Circuitos-Digitales-UNMSM-G2/Grupo-1---Proyecto-Digitales---Analizador-de-ocupacion-de-bandas-ISM/README.md

"# Grupo-1---Proyecto-Digitales---Analizador-de-ocupaci-n-de-bandas-ISM" 

# Grupo-1---Proyecto-Digitales---Analizador-de-ocupacion-de-bandas-ISM
