Circuitos-Digitales-UNMSM-G2/Grupo-1---Proyecto-Digitales---Analizador-de-ocupacion-de-bandas-ISM/ENTREGABLE 04 - Grupo 1/ENTREGABLE 4.pdf

# Analizador inteligente de ocupación en bandas ISM mediante sistema digital con

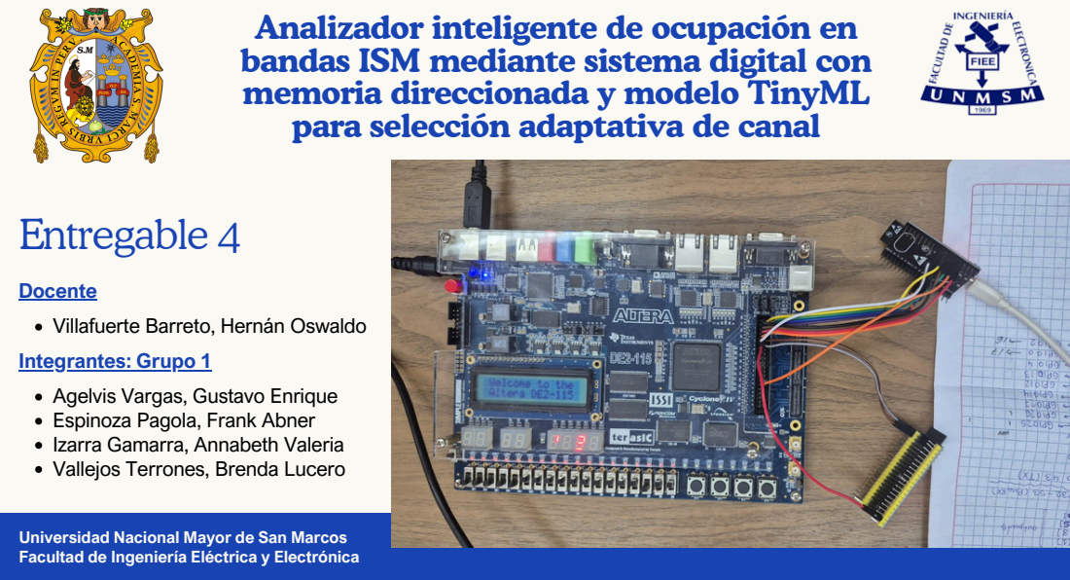
[picture p1: page 1]
Entregable 4

memoria direccionada y modelo TinyML
para selección adaptativa de canal

Docente
Villafuerte Barreto, Hernán Oswaldo
Integrantes: Grupo 1
Agelvis Vargas, Gustavo Enrique
Espinoza Pagola, Frank Abner
Izarra Gamarra, Annabeth Valeria
Vallejos Terrones, Brenda Lucero

Universidad Nacional Mayor de San Marcos
Facultad de Ingeniería Eléctrica y Electrónica

# HARDWARE Y CONEXIONES

# Diagrama de conexiones generales

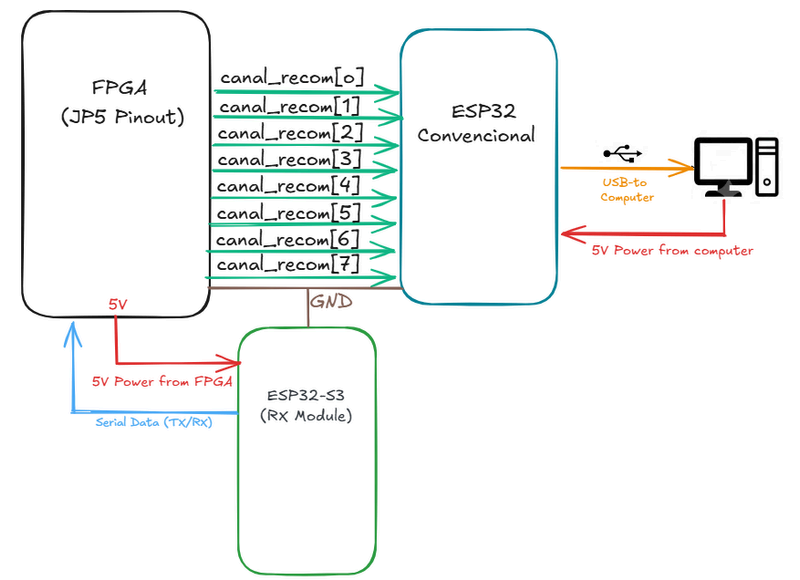
[picture p2: figure]

Pinout | Emisor

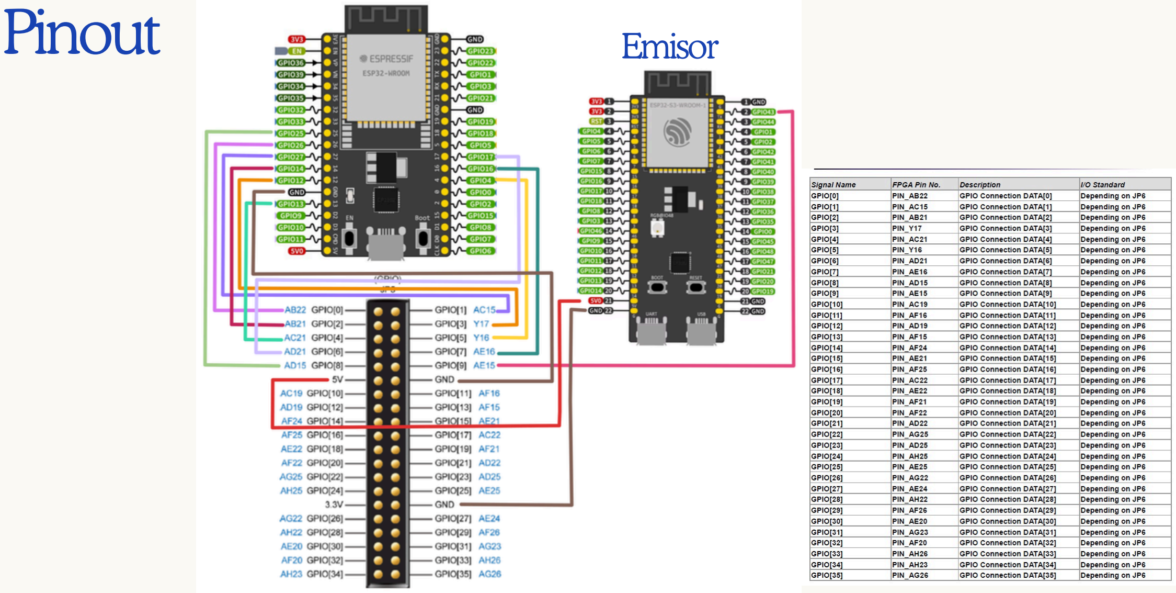
[picture p3: page 4]

SEÑAL FPGA | PIN FPGA | GPIO ESP32 | FUNCIÓN
canal_recomendado[0] | AB22 (GPIO0) | GPIO26 | Bit 0 del canal recomendado
canal_recomendado[1] | AC15 (GPIO1) | GPIO27 | Bit 1 del canal recomendado
canal_recomendado[2] | AB21 (GPIO2) | GPIO14 | Bit 2 del canal recomendado
canal_recomendado[3] | Y17 (GPIO3) | GPIO12 | Bit 3 del canal recomendado
canal_recomendado[4] | AC21 (GPIO4) | GPIO13 | Bit 4 del canal recomendado
canal_recomendado[5] | Y16 (GPIO5) | GPIO4 | Bit 5 del canal recomendado
canal_recomendado[6] | AD21 (GPIO6) | GPIO17 | Bit 6 del canal recomendado
canal_recomendado[7] | AE16 (GPIO7) | GPIO16 | Bit 7 del canal recomendado
output_valid | AD15 (GPIO8) | GPIO25 | Validación de datos

Conexión con ESP32-S3 (emisor)

UART RX (desde ESP32-S3) | AE15 (GPIO1) | GPIO43 (TX del ESP32-S3)

Recepción de datos de ocupación y RSSI

Alimentación y tierra

Tierra común | GND | GND | Referencia eléctrica común
Alimentación | 5V FPGA | 5V ESP32-S3 | Alimentación del módulo emisor

# Pinout

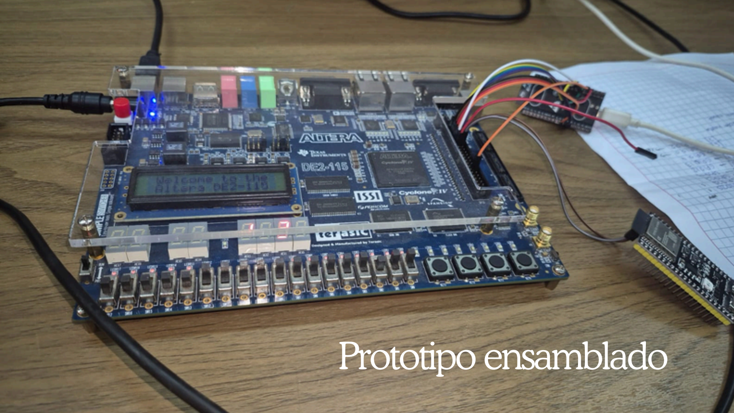
[picture p4: page 6]

# Prototipo ensamblado

# Prototipo ensamblado

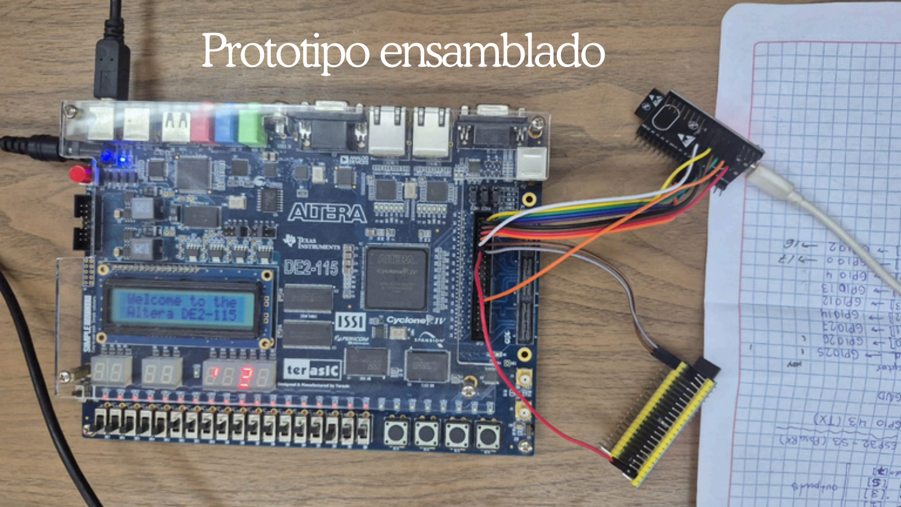
[picture p5: page 7]

RECURSO | UTILIZADO | DISPONIBLE | PORCENTAJE
Elementos lógicos (LUTs) | 350 | 114 480 | < 1 %
Funciones combinacionales | 272 | 114 480 | < 1 %

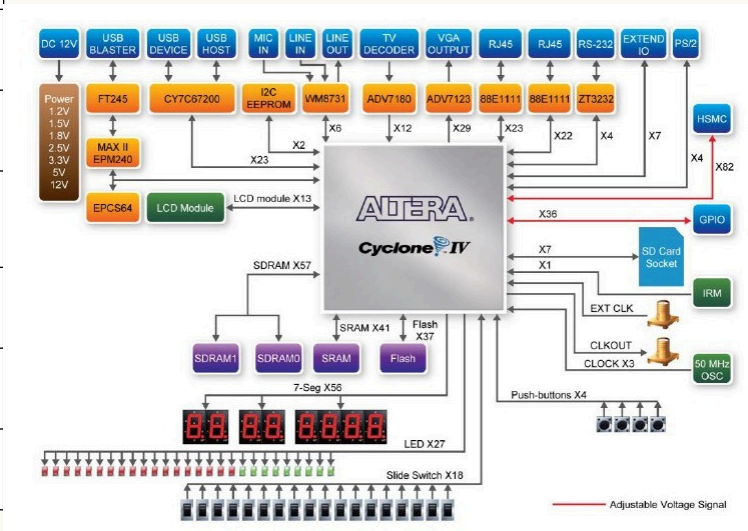
[picture p6: figure]

Registros dedicados (Flip-Flops) | 235 | 114 480 | < 1 %
Pines de entrada/salida (I/O) | 43 | 529 | 8%
Bits de memoria RAM | 0 | 3 981 312 | 0%
Bloques de memoria M9K | 0 | 432 | 0%
Multiplicadores embebidos de 9 bits | 0 | 532 | 0%
PLLs | 0 | 4 | 0%

# RECURSOS OCUPADOS DEL FPGA

El reporte de compilación muestra una ocupación muy reducida de los recursos disponibles de la FPGA. Se emplearon únicamente 350 elementos lógicos, 235 registros y 43 pines de entrada/salida, manteniendo un amplio margen de capacidad libre para futuras mejoras del sistema.

PROGRAMA | FUNCIÓN PRINCIPAL | PLATAFORMA

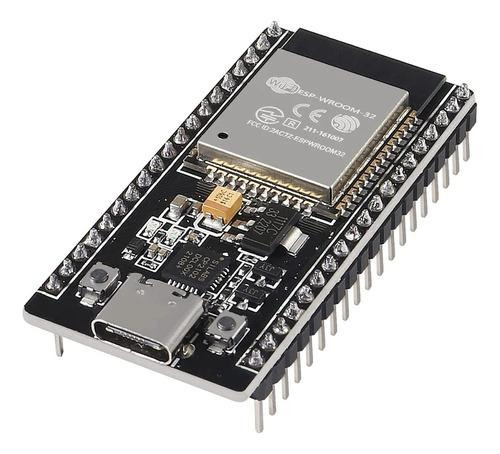
[picture p7: figure]

scanner_sender.ino | Escaneo de redes WiFi y envío de métricas a la FPGA mediante UART | ESP32-S3 DevKitC-1
ap_receiver.ino | Recepción del canal recomendado desde la FPGA y configuración de un punto de acceso WiFi | ESP32 Dev Module
simulator_sender.ino | Envío de escenarios simulados a la FPGA para pruebas y validación | ESP32
PROGRAMA | TAMAÑO DEL FIRMWARE (.bin)
scanner_sender | 676 528 bytes (660.67 KB)
ap_receiver | 733 920 bytes (716.72 KB)

# Recursos Ocupados en los ESP32

El sistema utiliza dos módulos ESP32 con funciones complementarias. El ESP32-S3 realiza el escaneo de redes WiFi y envía las métricas a la FPGA mediante UART, mientras que el ESP32 receptor interpreta el canal recomendado y configura un punto de acceso inalámbrico utilizando dicho canal.

## Memoria utilizada Los firmwares compilados presentan tamaños inferiores a 1 MB, lo que representa un uso moderado de la memoria Flash disponible en los

ESP32.

RECURSO | FUNCIÓN
Arduino.h | Funciones básicas del framework Arduino
WiFi.h | Escaneo y administración de redes WiFi
Serial | Comunicación serie con la computadora
Serial2 | Comunicación UART con la FPGA
digitalRead() | Lectura de entradas digitales
attachInterrupt() | Gestión de interrupciones
WiFi.scanNetworks() | Escaneo de redes inalámbricas
WiFi.softAP() | Creación de punto de acceso WiFi

# Recursossoftware

## El desarrollo emplea bibliotecas estándar del ecosistema Arduino y ESP32, incluyendo:

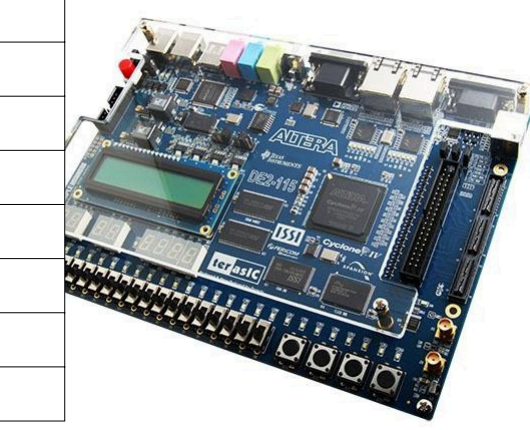
[picture p8: figure]

## Los módulos ESP32 funcionan como interfaces de adquisición y comunicación, mientras que el procesamiento principal se realiza en la FPGA. La arquitectura distribuye eficientemente las tareas y mantiene un bajo consumo de recursos de memoria y

almacenamiento.

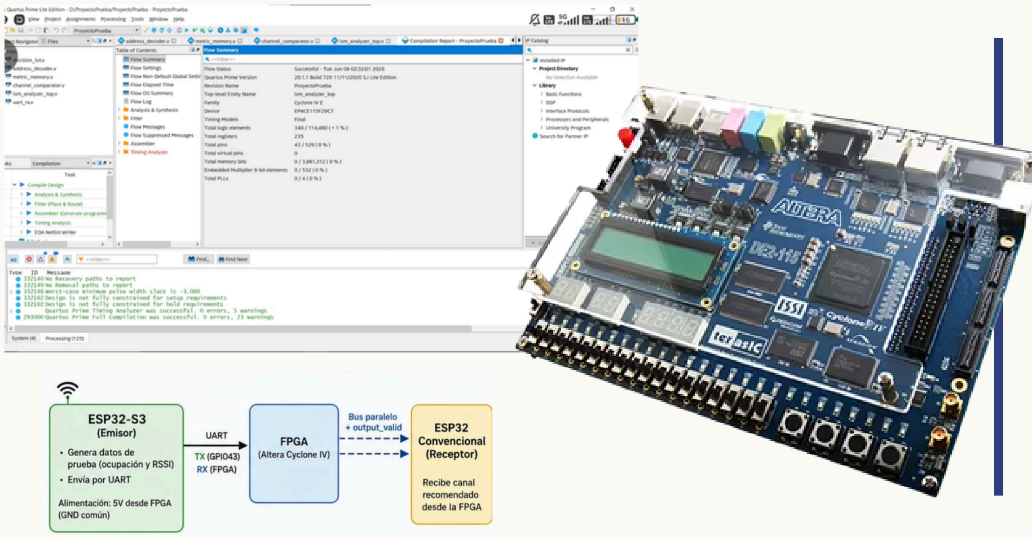
[picture p9: page 11]

CANAL | RSSI (%) | OCUPACIÓN (%)
Canal 1 | 75 | 55
Canal 6 | 65 | 15
Canal 11 | 60 | 60

# MEDICIÓN DE MÉTRICAS INICIALES

Los módulos ESP32 funcionan como interfaces de adquisición y comunicación, mientras que el procesamiento principal se realiza en la FPGA. La arquitectura distribuye eficientemente las tareas y mantiene un bajo consumo de recursos de memoria y almacenamiento.

# Escenario de prueba

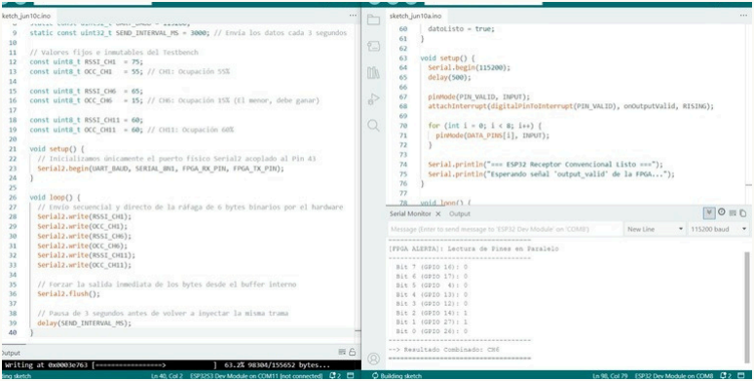
[picture p10: figure]

## Resultado esperado Canal recomendado = CH6 Porque presenta el menor nivel de

ocupación.

PARÁMETRO | VALOR
Tiempo por bit UART | 8.68 µs
Tiempo por byte UART | 86.8 µs
Número de bytes transmitidos | 6
Tiempo total de transmisión | 520.8 µs
Pausa agregada por testbench | 120 µs
Tiempo de procesamiento FPGA | 0.24 µs
Tiempo total estimado | 641.04 µs
PARÁMETRO | SIMULACIÓN | HARDWARE REAL
Canal recomendado | CH6 | CH6
Valor binario obtenido | 110 | 110
Valor decimal obtenido | 6 | 6
Señal output_valid | Activa | Activa
Resultado esperado | Correcto | Correcto
Tiempo de respuesta aproximado | 641.04 µs | 520.8 µs + procesamiento

# MEDICIÓN DE MÉTRICAS INICIALES

# Parámetros delsistema Resultados Simulados vs Reales

# Análisis y contraste

Simulación y hardware obtuvieron el mismo resultado (Canal 6).
La simulación presentó mayor latencia debido a retardos añadidos en el testbench.
La FPGA opera a 50 MHz, muy por debajo de su Fmax de 157.28 MHz, garantizando un funcionamiento estable. La baja utilización de recursos permite futuras ampliaciones del sistema sin afectar el rendimiento.

# ESP32 -WROOM32

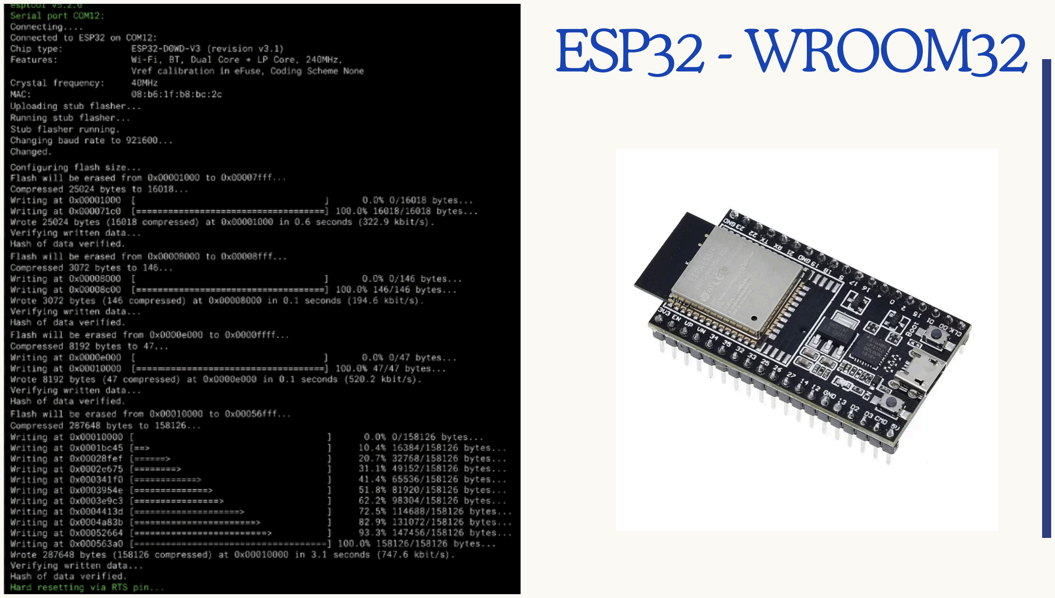
[picture p11: page 14]

# ESP32-S3 Dev Kit

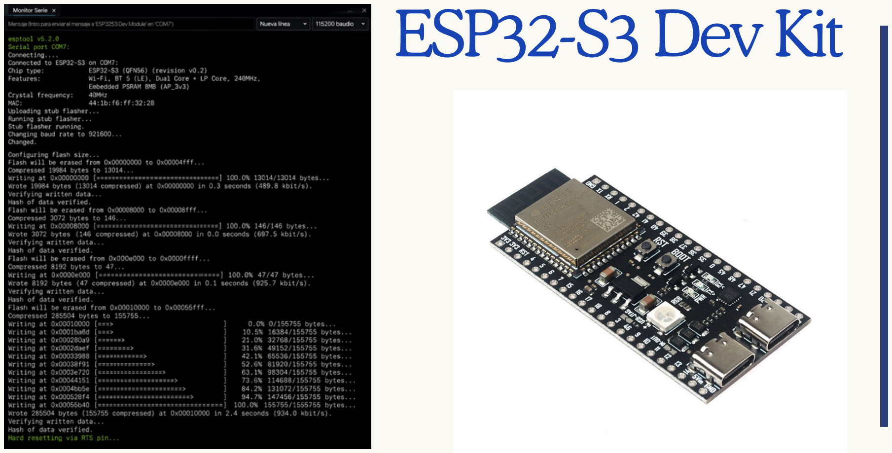
[picture p12: page 15]

# EVIDENCIA DE FUNCIONAMIENTO

# hht

t

t

# tppss

:/
:

/

# /y/yoouut

# tuu.b

# .bee/Z/Zwwhhxx

# zzbbEEeeRRf4f (https://youtu.be/ZwhxzbEeRf4)4 (https://youtu.be/ZwhxzbEeRf4)

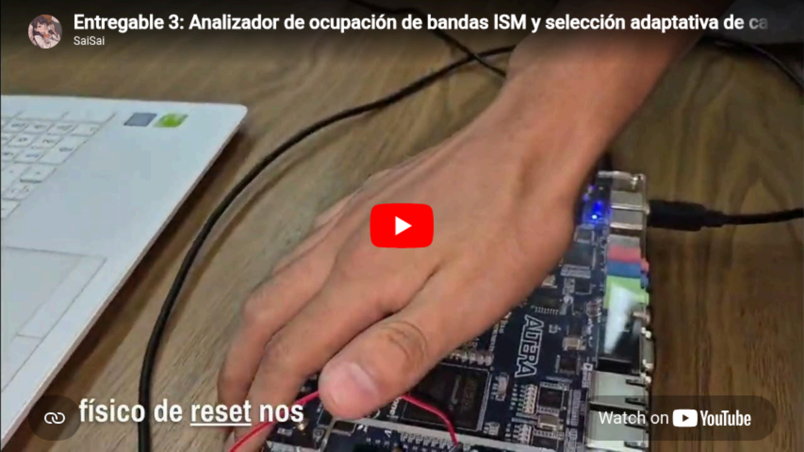
[picture p13: page 17]

# Sección 1: Prototipo físico ensamblado y funcional

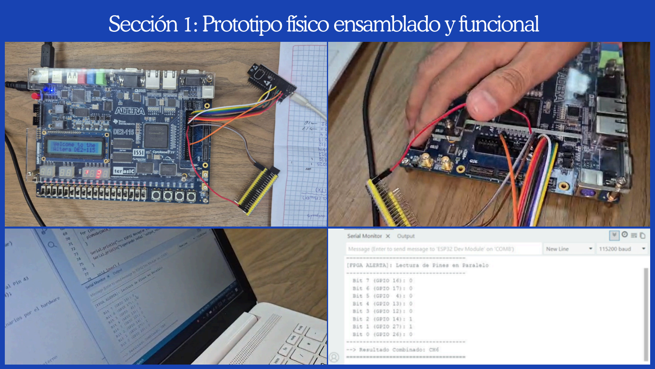
[picture p14: page 18]

Sección 2: Resultado de la lógica de decisión del prototipo físico en monitorserial.

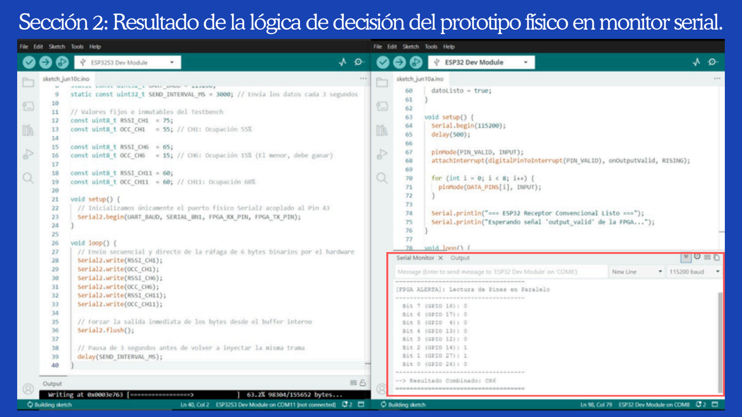
[picture p15: page 19]

# Sección 3:

# Testbench

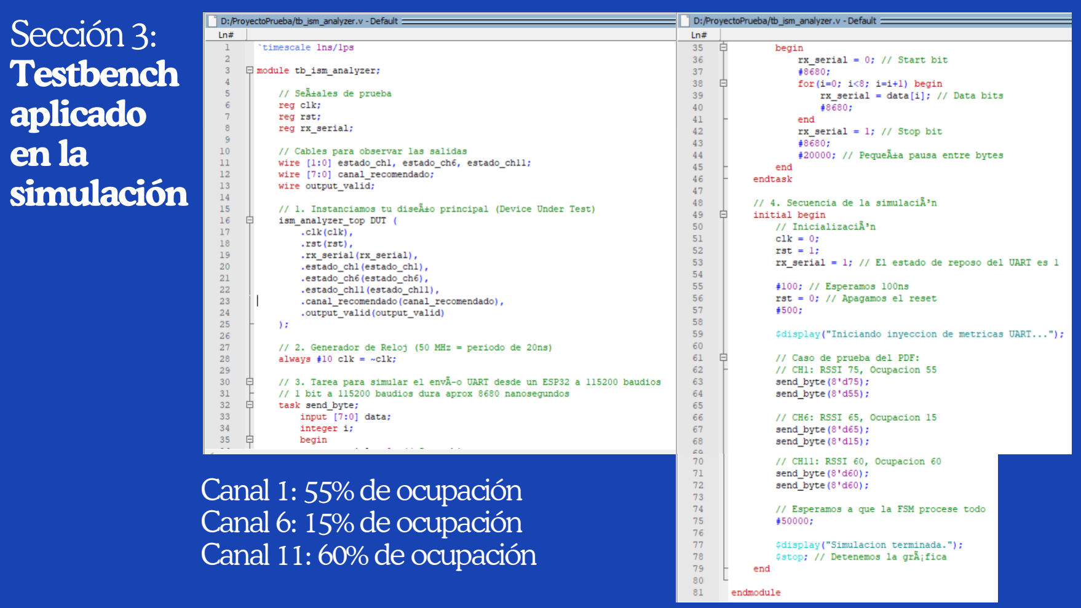
[picture p16: page 20]

# aplicado en la simulación

# Canal 1: 55% de ocupación Canal 6: 15% de ocupación Canal 11: 60% de ocupación

# Sección 4: Resultado de la simulación tras aplicación del testbench

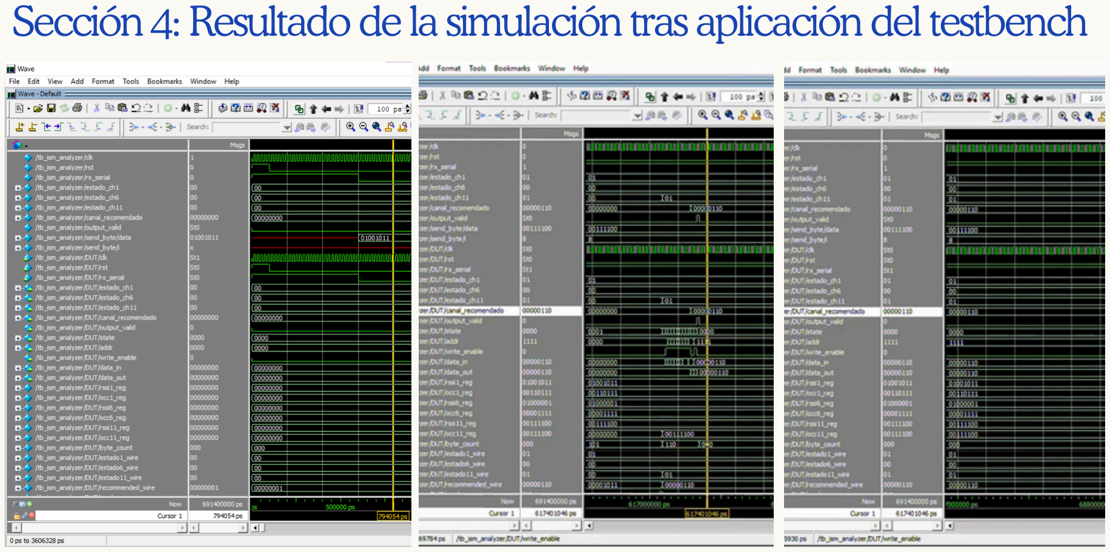
[picture p17: page 21]

# Presentación del Proyecto

# Materiales

## El proyecto implementa un sistema digital capaz de analizar métricas de ocupación de canales WiFi en la banda ISM, almacenar

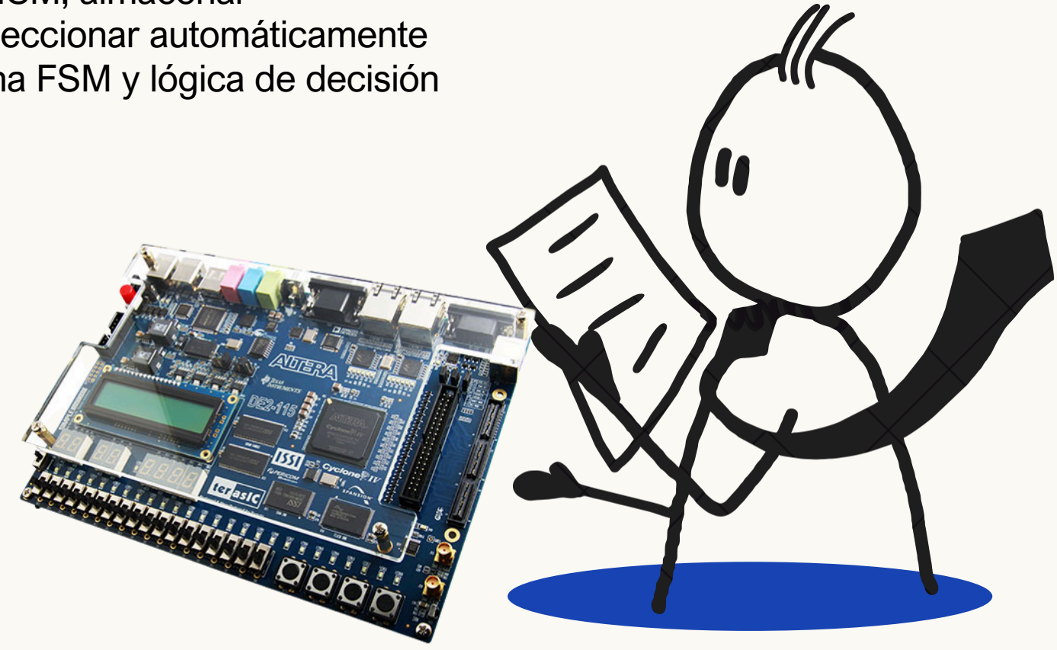
[picture p18: figure]

## información en memoria direccionada y seleccionar automáticamente el canal menos congestionado mediante una FSM y lógica de decisión

LUT implementadas en FPGA.

## FPGA DE2-115 (Cyclone IV E) ESP32-S3 Laptop con Quartus Prime y ModelSim Cable USB-Blaster

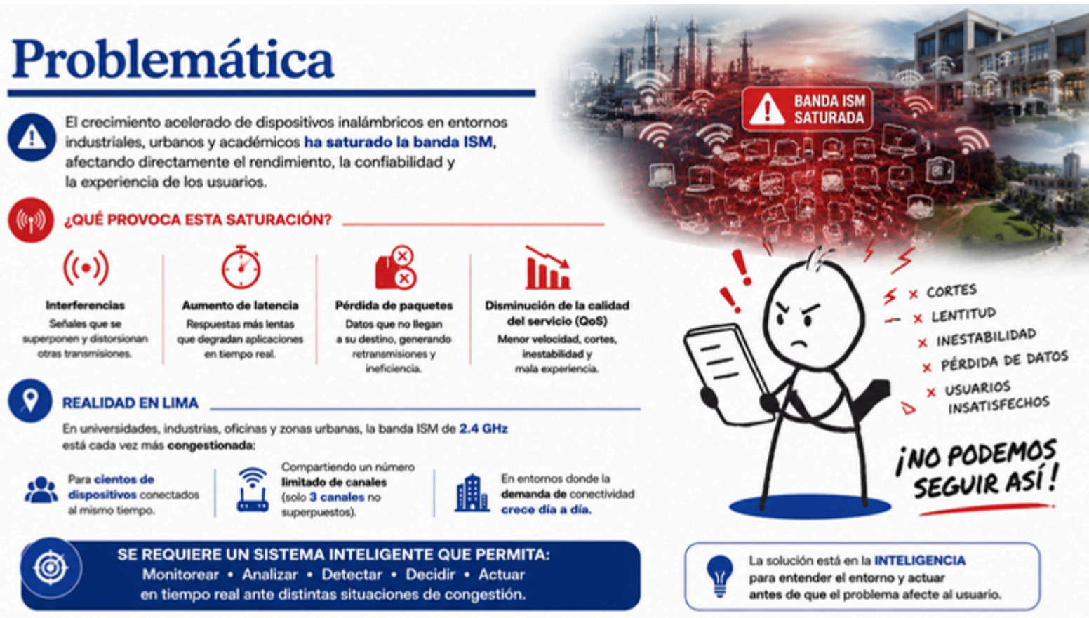
[picture p19: page 24]

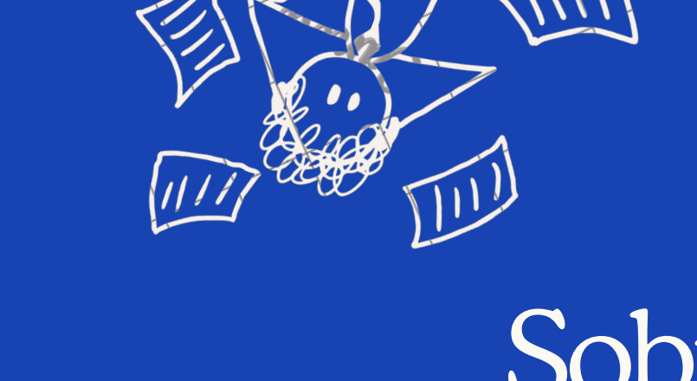
[picture p20: figure]
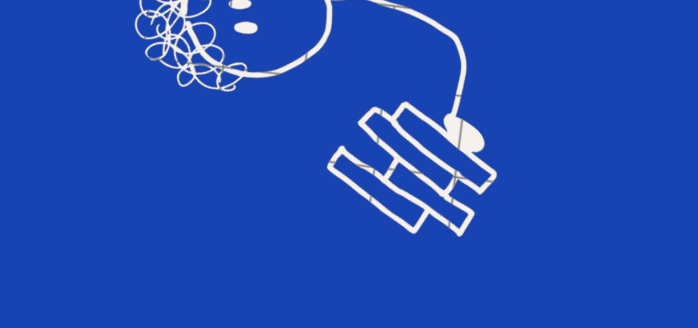
[picture p21: figure]

# Sobre la situación actual

La situación está en que muchas tecnologías no plantean un mecanismo local tanto económico como autónomo

## que pueda analizar la actividad de distintas bandas

Este dispositivo se basaría en parámetros como calidad de transmisión, potencia, entre otros para poder tomar decisiones digitales que mejoren el desempeño del enlace. Lo cual, cuando se observa el sector IoT notamos que muchos utilizan configuraciones estáticas sin considerar lo mencionado anteriormente.

Abdelghany, A., Uguen, B., Moy, C., & Lemur, D. (2022). Decentralized Adaptive Spectrum Learning in Wireless IoT Networks Based on Channel Quality Information.

# Fuente

# Objetivos

# Generales

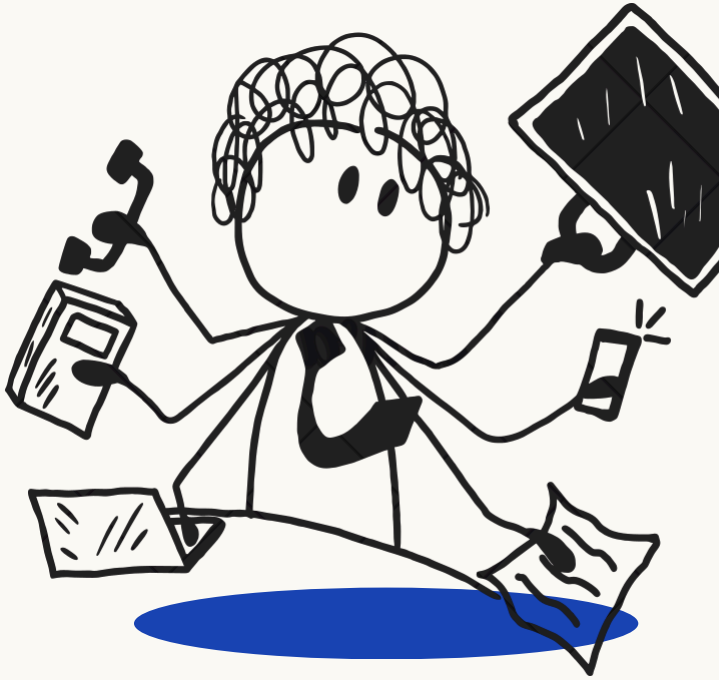
[picture p22: figure]

# Específicos

Diseñar una FSM para controlar el flujo del sistema.

## Implementar memoria direccionada y decodificador de

direcciones.

## Validar mediante simulación funcional la selección automática

del canal menos congestionado.

## Desarrollar un sistema digital inteligente para análisis y selección

adaptativa de canales en banda ISM utilizando FPGA.

En un entorno industrial con múltiples dispositivos IoT, redes WiFi,

## sensores NB-IoT, cámaras y sistemas de automatización transmitiendo simultáneamente en la banda ISM, puede producirse congestión e interferencia que afecte la estabilidad y latencia de las

comunicaciones críticas.

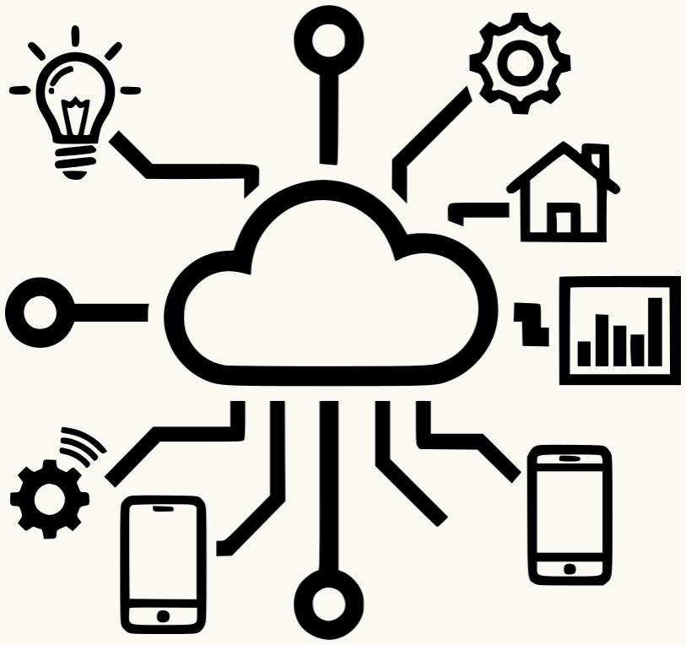
[picture p23: figure]

En este escenario, el sistema propuesto monitorea continuamente la ocupación de los canales inalámbricos mediante el ESP32-S3 y envía las métricas hacia la FPGA, donde son procesadas en tiempo real mediante FSM, memoria direccionada y lógica de decisión LUT para identificar el canal menos congestionado. Esto permite recomendar o ejecutar cambios dinámicos de canal para mantener una comunicación más estable, reducir pérdida de paquetes y mejorar la

confiabilidad de sistemas industriales conectados.

# Casos de uso

## A diferencia de un microcontrolador convencional, la FPGA puede controlar simultáneamente módulos de memoria, decodificación de direcciones, clasificación LUT y comparación de canales mediante una FSM dedicada

El uso de una FPGA permite implementar el procesamiento y la toma de decisiones directamente en

## hardware digital, logrando una ejecución paralela y determinística con baja latencia

# Valor agregado

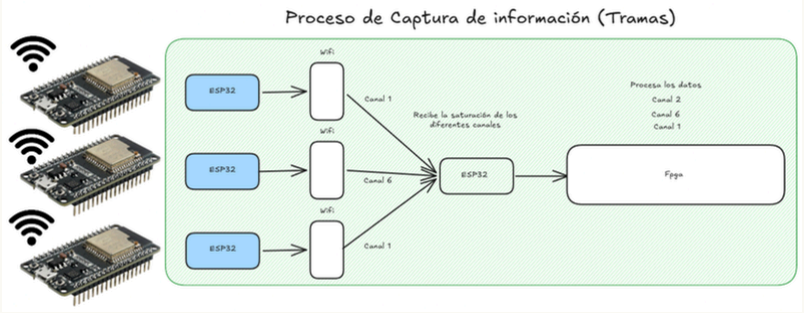
[picture p24: figure]

# De forma general la propuesta de proyecto

# Diagrama de bloques

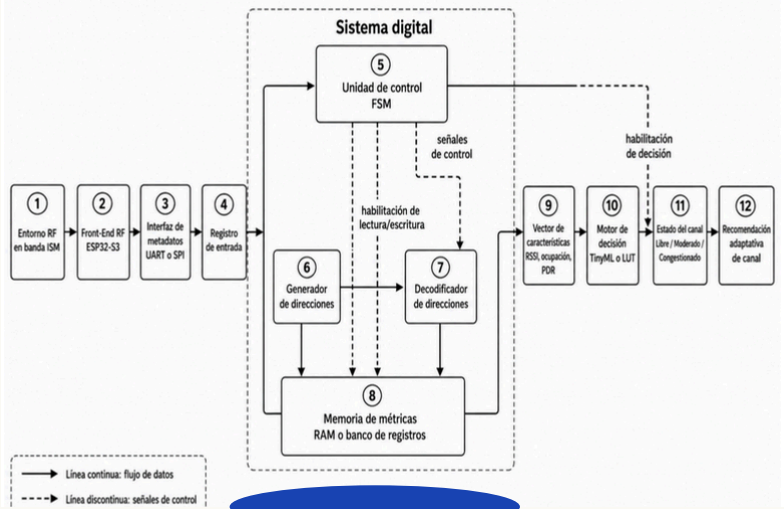
[picture p25: figure]

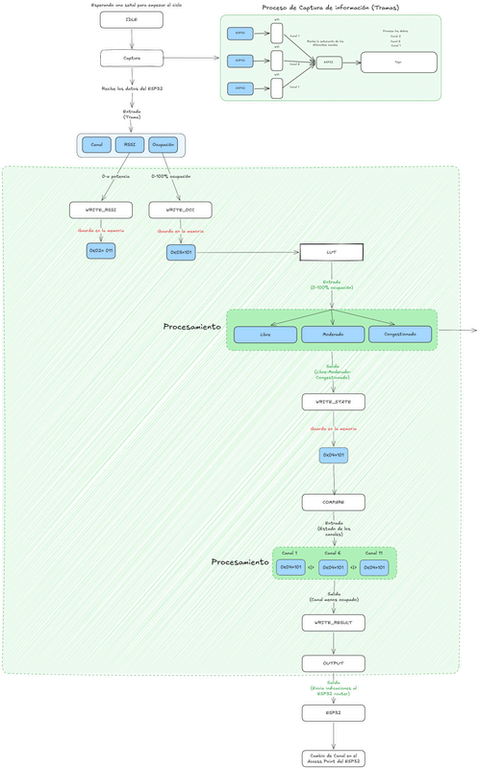
[picture p26: figure]

# Arquitectura delsistema

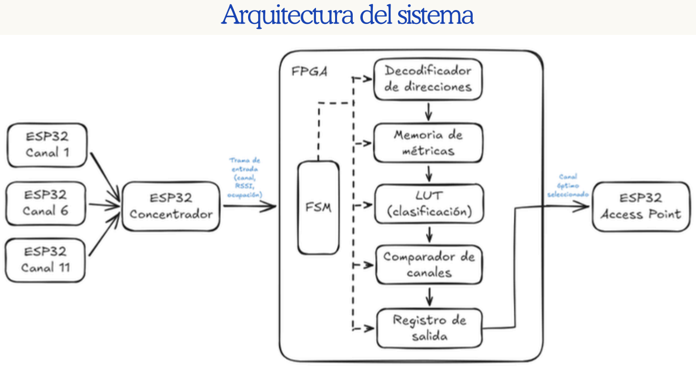
[picture p27: page 32]

# Máquina de estadosfinitos(FSM)

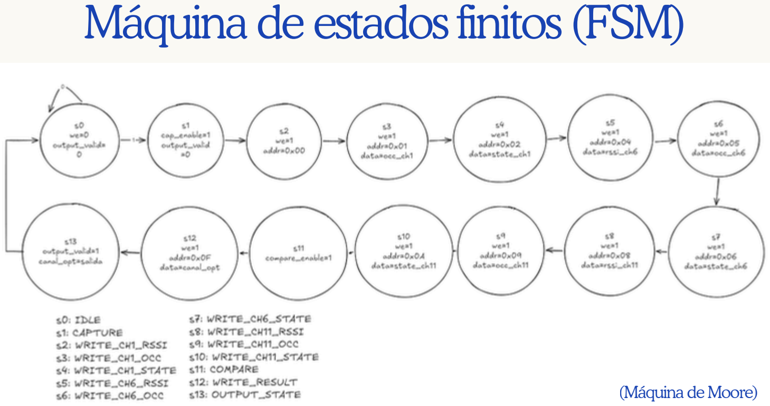
[picture p28: page 33]

# (Máquina de Moore)

Código | Estado | Función | Siguiente estado
0 | IDLE | Espera una trama válida | CAPTURE si data_valid = 1
1 | CAPTURE | Captura RSSI y ocupación de los canales 1, 6 y 11 | WRITE_CH1_RSSI
2 | WRITE_CH1_RSSI | Escribe RSSI del canal 1 en memoria | WRITE_CH1_OCC
3 | WRITE_CH1_OCC | Escribe ocupación del canal 1 | WRITE_CH1_STATE
4 | WRITE_CH1_STATE | Escribe estado clasificado del canal 1 | WRITE_CH6_RSSI
5 | WRITE_CH6_RSSI | Escribe RSSI del canal 6 en memoria | WRITE_CH6_OCC
6 | WRITE_CH6_OCC | Escribe ocupación del canal 6 | WRITE_CH6_STATE
7 | WRITE_CH6_STATE | Escribe estado clasificado del canal 6 | WRITE_CH11_RSSI
8 | WRITE_CH11_RSSI | Escribe RSSI del canal 11 en memoria | WRITE_CH11_OCC
9 | WRITE_CH11_OCC | Escribe ocupación del canal 11 | WRITE_CH11_STATE
10 | WRITE_CH11_STATE | Escribe estado clasificado del canal 11 | COMPARE
11 | COMPARE | Compara ocupaciones y obtiene el canal menos ocupado | WRITE_RESULT
12 | WRITE_RESULT | Escribe el canal recomendado en memoria | OUTPUT STATE
13 | OUTPUT STATE | Activa output_valid y entrega el resultado | IDLE

# Tabla de estados de la FSM

# Diagrama ASM

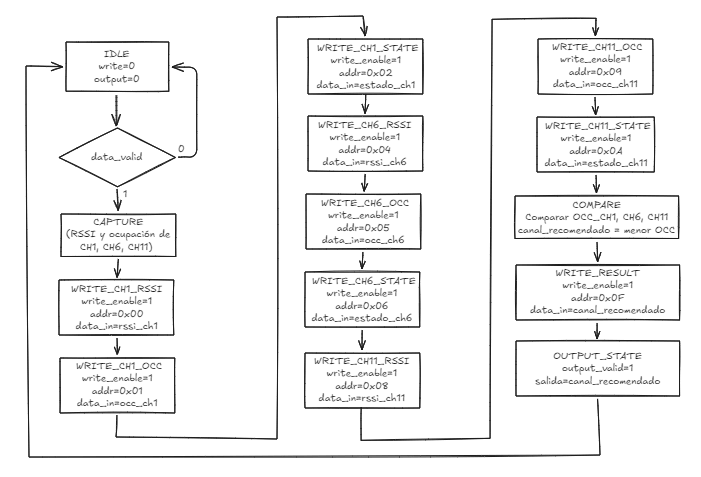
[picture p29: page 35]

# CÓDIGO Y PSEUDOCÓDIGO

# 1.Módulo LUT para la decisión

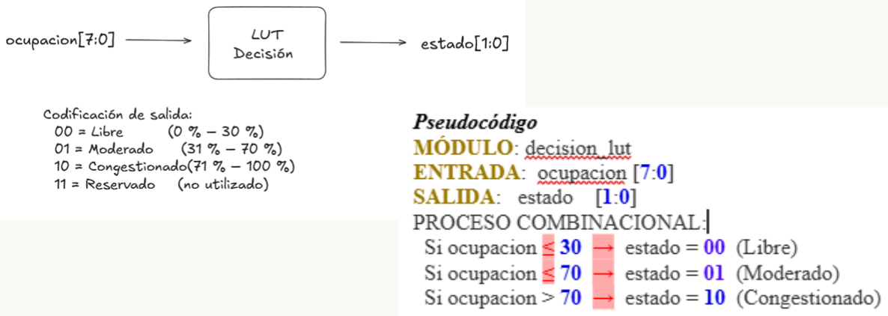
[picture p30: figure]

# Módulo decodificador de direcciones

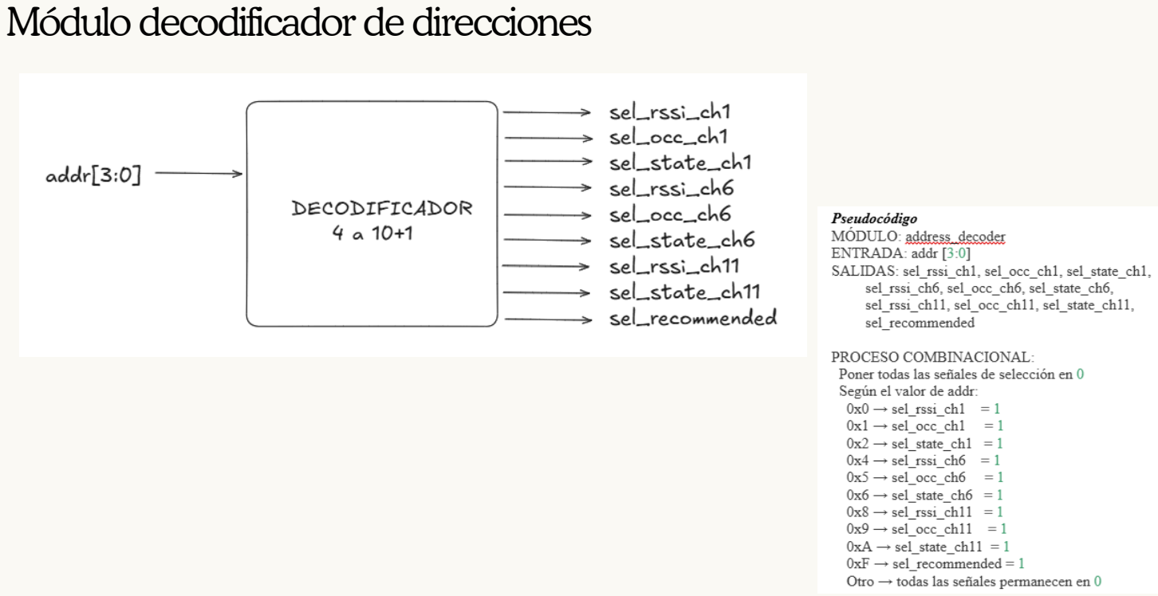
[picture p31: page 37]

# Módulo memoria de métricas

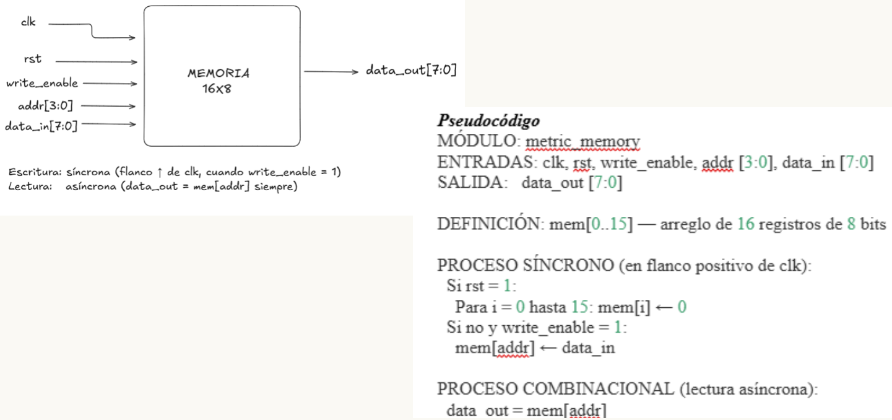
[picture p32: figure]

# Módulo comparador de canales

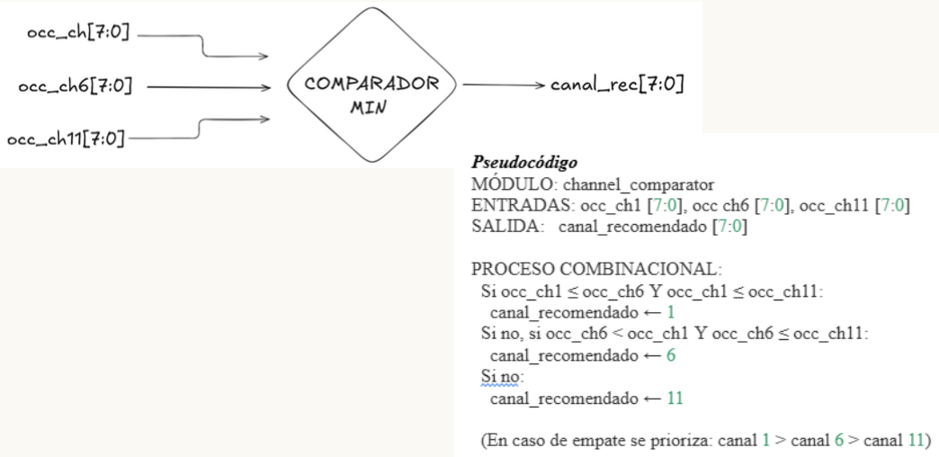
[picture p33: figure]

# Simulación

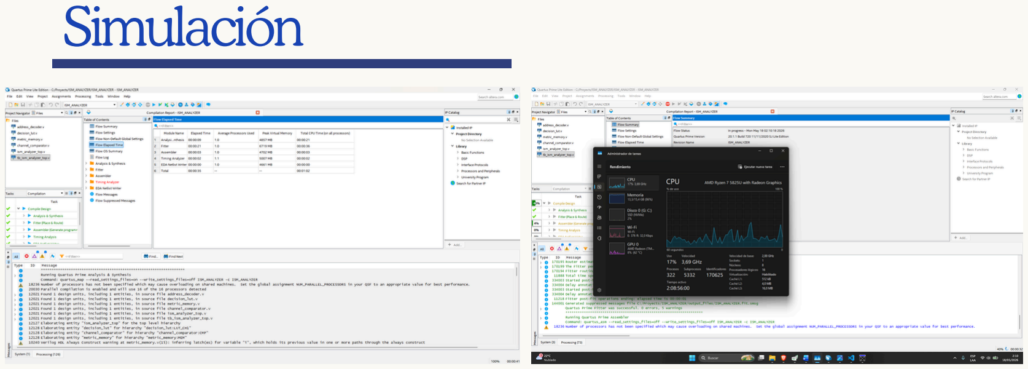
[picture p34: page 40]
